hydronics2/Teardown-2019/README.md

# Teardown 2019 - Soldering and Web BLE tutorial
This is a soldering and programming class in Circuitpython that includes a Web Ble demo

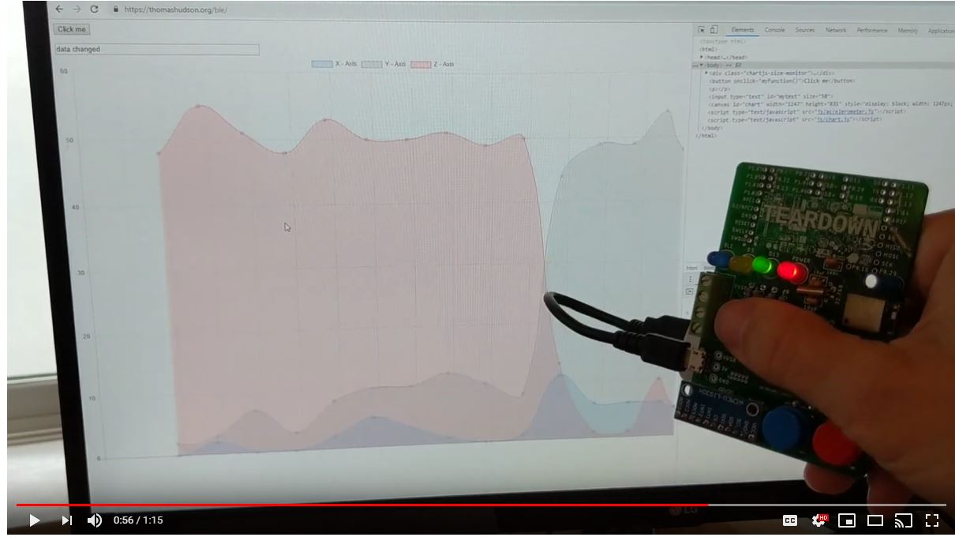
[picture p1: front_pic.JPG]
IMAGE ALT TEXT HERE (https://youtu.be/q24QmTUplko)


[github.com/hydronics2/Teardown-2019](https://github.com/hydronics2/Teardown-2019)

This class occurs in two parts -- Soldering and Programming.

We'll be soldering parts and headers  onto a custom printed circuit board(PCB).  
This board is a copy of the [Adafruit Feather nrf52840 express](https://www.adafruit.com/product/4062).  

When you connect from USB to your computer it shows up as an external hard drive with pre-loaded example scripts.

[Soldering Tutorial](https://github.com/hydronics2/Teardown-2019/blob/master/soldering/README.md)

[Programming Tutorial](https://github.com/hydronics2/Teardown-2019/blob/master/programming/README.md)

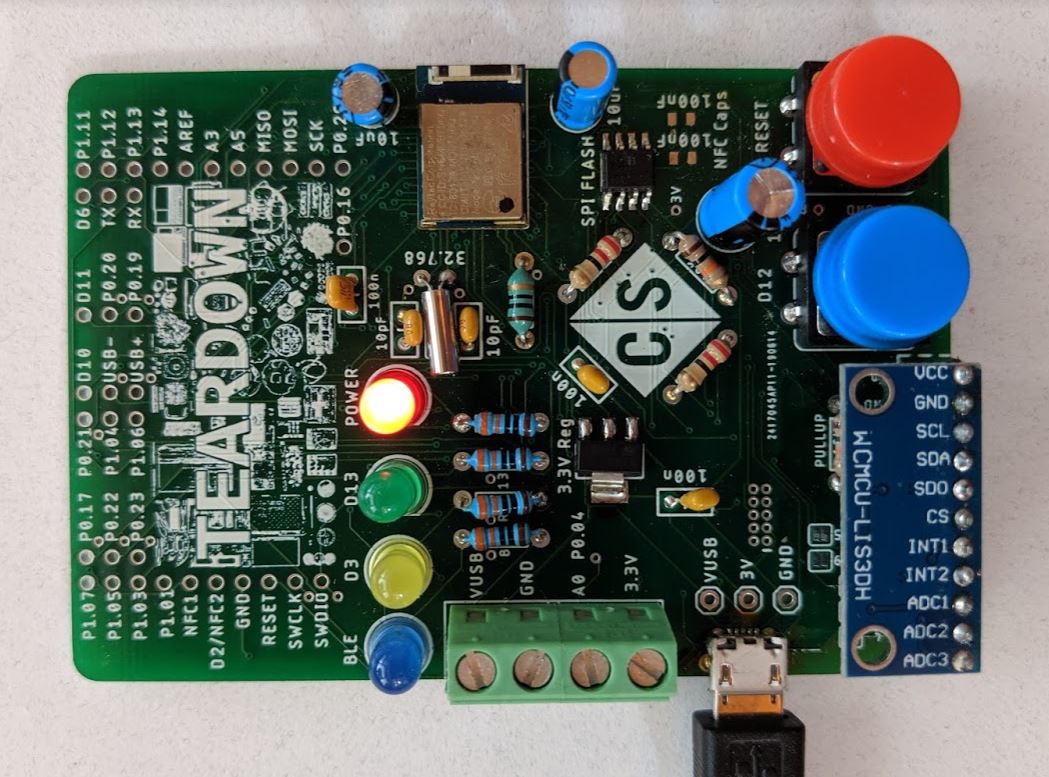
[picture p2: top.JPG]


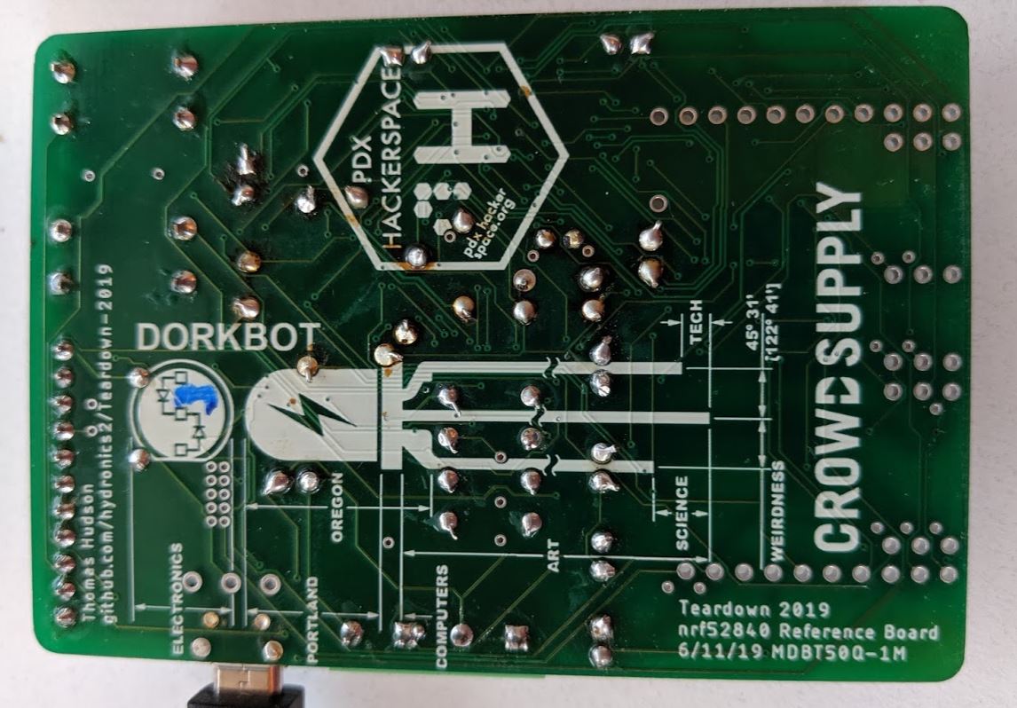
[picture p3: bottome.JPG]
