hydronics2/Teardown-2019/programming/pics/photocell.JPG

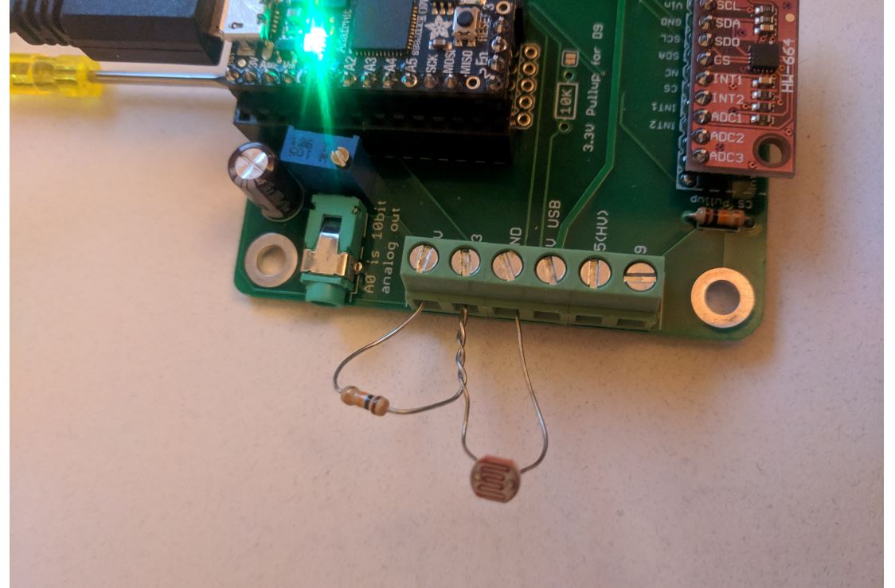
programming/pics/photocell.JPG
