hydronics2/Teardown-2019/soldering/eagle_design_files/blank_bottom.JPG

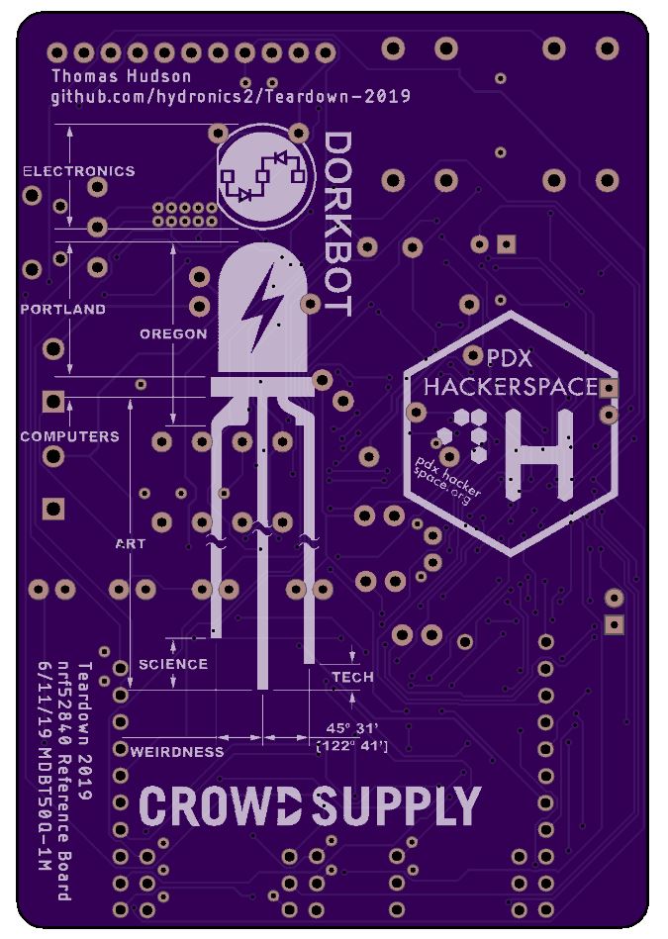
soldering/eagle_design_files/blank_bottom.JPG
