hydronics2/Teardown-2019/soldering/pics/schematic.JPG

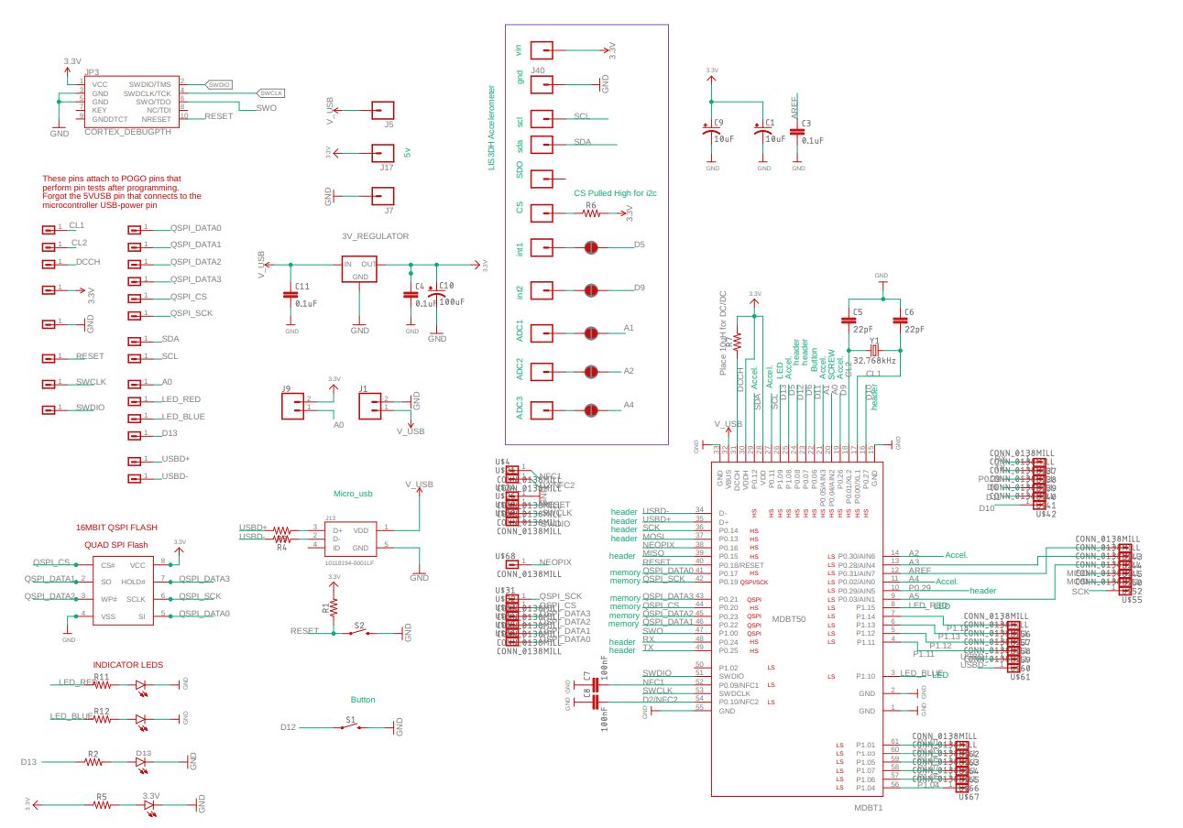
soldering/pics/schematic.JPG
