hydronics2/Teardown-2019/soldering/eagle_design_files/test-jig/README.md

# Test Jig

This test jig accepted pogo pins. Once the nrf52840 was put on the board, I used this test jig to verify all the pins were functional; that is, all the BGA(like) pads were successfully soldered. 

... need a picture of the test jig here...
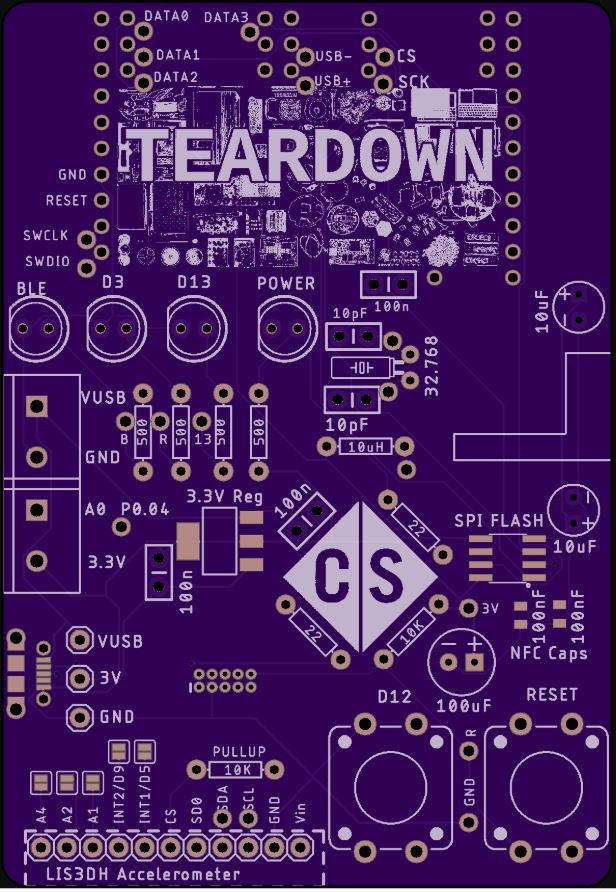
[picture p43: soldering/eagle_design_files/test-jig/test_jig_top.JPG]
test_jig
