hydronics2/Teardown-2019/soldering/eagle_design_files/class_nrf52840v2_module.sch

## EAGLE design soldering/eagle_design_files/class_nrf52840v2_module.sch (2019-06-23)

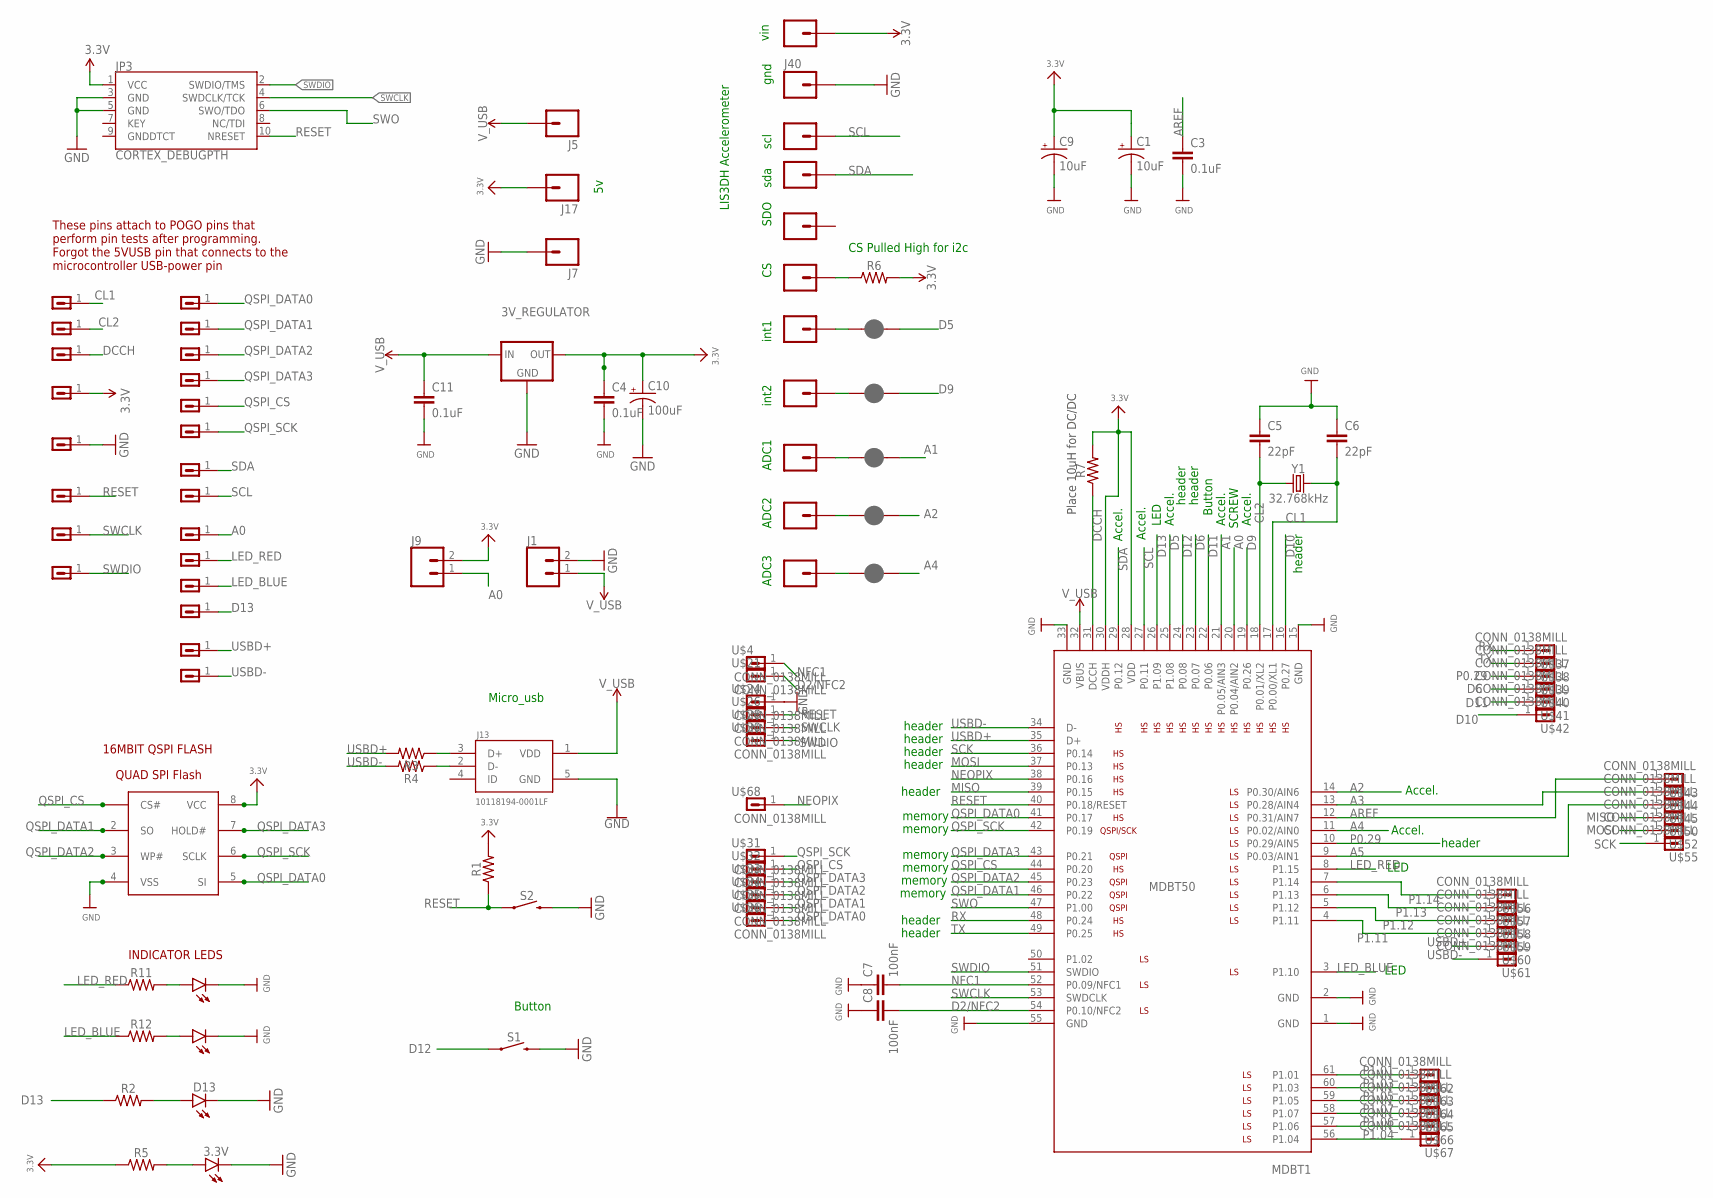
[picture p44: schematic class_nrf52840v2_module.sch]

Parts:
3.3V: LED5MM-KIT
3V_REGULATOR: LDL1117_5V_REG; SOT223
C1, C9: 10uF; CPOL-RADIAL-2.5MM-5MM-KIT
C3, C4, C11: 0.1uF; CAP-PTH-SMALL-KIT
C5, C6: 22pF; CAP-PTH-SMALL-KIT
C7, C8: 100nF; 0805
C10: 100uF; CPOL-RADIAL-2.5MM-6.5MM
D2, D3, D13: LED5MM-KIT
J1, J9: CONN_025MM; SCREWTERMINAL-5MM-2
J5, J7, J17, J22, J23, J24, J25, J26, J27, J39, J40, J42, J43, J44: M01PTH; 1X01
J13: 10118194-0001LF; FRAMATOME_10118194-0001LF
JP1, JP2, JP4, JP6, JP7: JUMPER-SMT_2_NC_PASTE_SILK; SMT-JUMPER_2_NC_PASTE_SILK
JP3: CORTEX_DEBUGPTH; 2X5-PTH-1.27MM
MDBT1: MDBT50
R1, R2, R3, R4, R5, R6, R7, R11, R12: AXIAL-0.3
S1, S2: MOMENTARY-SWITCH-SPST-PTH-12MM; TACTILE_SWITCH_PTH_12MM
U$4, U$21, U$24, U$26, U$28, U$30, U$31, U$32, U$33, U$34, U$35, U$36, U$37, U$38, U$39, U$40, U$41, U$42, U$43, U$44, U$45, U$50, U$52, U$55, U$56, U$57, U$58, U$59, U$60, U$61, U$62, U$63, U$64, U$65, U$66, U$67, U$68: CONN_0138MILL; 1X01-40MILL
U$13, U$18, U$19, U$20, U$22, U$23, U$69, U$70, U$71, U$72, U$73, U$74, U$75, U$76, U$77, U$78, U$79, U$80, U$81, U$82, U$83, U$84: CONN_011.27MM; 1X01-1.27MM
U$29: QUAD_SPI_FLASHSOIC8_300MIL; SOIC8
Y1: 32.768kHz; CRYSTAL-PTH-2X6-CYL

Connections:
3.3V: 3V_REGULATOR.2 (OUT), C1.1 (+), C4.1, C9.1 (+), C10.1 (+), J9.2, J17.1, J22.1, JP3.1 (VCC), MDBT1.28 (VDD), MDBT1.30 (VDDH), R1.P$2 (2), R5.P$1 (1), R6.P$2 (2), R7.P$2 (2), U$18.1, U$29.8 (VCC)
A0: J9.1, MDBT1.20 (P0.04/AIN2), U$76.1
A1: JP4.2, MDBT1.21 (P0.05/AIN3)
A2: JP6.2, MDBT1.14 (P0.30/AIN6)
A3: MDBT1.13 (P0.28/AIN4), U$44.1
A4: JP7.2, MDBT1.11 (P0.02/AIN0)
A5: MDBT1.9 (P0.03/AIN1), U$45.1
AREF: C3.1, MDBT1.12 (P0.31/AIN7), U$43.1
CL1: C6.2, MDBT1.17 (P0.00/XL1), U$82.1, Y1.2
CL2: C5.2, MDBT1.18 (P0.01/XL2), U$83.1, Y1.1
D2/NFC2: C8.2, MDBT1.54 (P0.10/NFC2), U$21.1
D5: JP1.2, MDBT1.25 (P1.08)
D6: MDBT1.23 (P0.07), U$40.1
D9: JP2.2, MDBT1.19 (P0.26)
D10: MDBT1.16 (P0.27), U$42.1
D11: MDBT1.22 (P0.06), U$41.1
D12: MDBT1.24 (P0.08), S1.1
D13: MDBT1.26 (P1.09), R2.P$1 (1), U$79.1
DCCH: MDBT1.31 (DCCH), R7.P$1 (1), U$84.1
GND: 3.3V.K (C), 3V_REGULATOR.1 (GND), C1.2 (-), C3.2, C4.2, C5.1, C6.1, C7.1, C8.1, C9.2 (-), C10.2 (-), C11.2, D2.K (C), D3.K (C), D13.K (C), J1.2, J7.1, J13.5 (GND), J40.1, JP3.3 (GND), JP3.5 (GND), MDBT1.1 (GND), MDBT1.2 (GND), MDBT1.15 (GND), MDBT1.33 (GND), MDBT1.55 (GND), S1.3 (2), S2.3 (2), U$13.1, U$24.1, U$29.4 (VSS)
LED_BLUE: MDBT1.3 (P1.10), R12.P$1 (1), U$78.1
LED_RED: MDBT1.8 (P1.15), R11.P$1 (1), U$77.1
MISO: MDBT1.39 (P0.15), U$50.1
MOSI: MDBT1.37 (P0.13), U$52.1
unnamed: D3.A, R11.P$2 (2)
unnamed: J13.3 (D+), R3.P$1 (1)
unnamed: J13.2 (D-), R4.P$1 (1)
unnamed: J25.1, JP4.1
unnamed: J24.1, JP6.1
unnamed: J27.1, JP7.1
unnamed: D2.A, R12.P$2 (2)
unnamed: J26.1, JP2.1
unnamed: J44.1, JP1.1
unnamed: J23.1, R6.P$1 (1)
unnamed: 3.3V.A, R5.P$2 (2)
unnamed: D13.A, R2.P$2 (2)
NEOPIX: MDBT1.38 (P0.16), U$68.1
NFC1: C7.2, MDBT1.52 (P0.09/NFC1), U$4.1
P0.29: MDBT1.10 (P0.29/AIN5), U$39.1
P1.01: MDBT1.61 (P1.01), U$62.1
P1.03: MDBT1.60 (P1.03), U$63.1
P1.04: MDBT1.56 (P1.04), U$67.1
P1.05: MDBT1.59 (P1.05), U$64.1
P1.06: MDBT1.57 (P1.06), U$66.1
P1.07: MDBT1.58 (P1.07), U$65.1
P1.11: MDBT1.4 (P1.11), U$59.1
P1.12: MDBT1.5 (P1.12), U$58.1
P1.13: MDBT1.6 (P1.13), U$57.1
P1.14: MDBT1.7 (P1.14), U$56.1
QSPI_CS: MDBT1.44 (P0.20), U$29.1 (CS#), U$32.1, U$72.1
QSPI_DATA0: MDBT1.41 (P0.17), U$23.1, U$29.5 (SI), U$36.1
QSPI_DATA1: MDBT1.46 (P0.22), U$29.2 (SO), U$35.1, U$69.1
QSPI_DATA2: MDBT1.45 (P0.23), U$29.3 (WP#), U$34.1, U$70.1
QSPI_DATA3: MDBT1.43 (P0.21), U$29.7 (HOLD#), U$33.1, U$71.1
QSPI_SCK: MDBT1.42 (P0.19), U$29.6 (SCLK), U$31.1, U$73.1
RESET: JP3.10 (NRESET), MDBT1.40 (P0.18/RESET), R1.P$1 (1), S2.1, U$20.1, U$26.1
RX: MDBT1.48 (P0.24), U$37.1
SCK: MDBT1.36 (P0.14), U$55.1
SCL: J43.1, MDBT1.27 (P0.11), U$75.1
SDA: J42.1, MDBT1.29 (P0.12), U$74.1
SWCLK: JP3.4 (SWDCLK/TCK), MDBT1.53 (SWDCLK), U$22.1, U$28.1
SWDIO: JP3.2 (SWDIO/TMS), MDBT1.51 (SWDIO), U$19.1, U$30.1
SWO: JP3.6 (SWO/TDO), MDBT1.47 (P1.00)
TX: MDBT1.49 (P0.25), U$38.1
USBD+: MDBT1.35 (D+), R3.P$2 (2), U$60.1, U$80.1
USBD-: MDBT1.34 (D-), R4.P$2 (2), U$61.1, U$81.1
V_USB: 3V_REGULATOR.3 (IN), C11.1, J1.1, J5.1, J13.1 (VDD), MDBT1.32 (VBUS)

Notes on the sheet:
Micro_usb
Place 10uH for DC/DC
16MBIT QSPI FLASH
INDICATOR LEDS
vin
SDO
gnd
sda
scl
int1
LIS3DH Accelerometer
CS Pulled High for i2c
int2
LED
Accel.
ADC1
ADC2
ADC3
SCREW
memory
header
Button
These pins attach to POGO pins that perform pin tests after programming. Forgot the 5VUSB pin that connects to the microcontroller USB-power pin
