hydronics2/Teardown-2019/soldering/eagle_design_files/test-jig/test_jig.sch

## EAGLE design soldering/eagle_design_files/test-jig/test_jig.sch (2019-06-23)

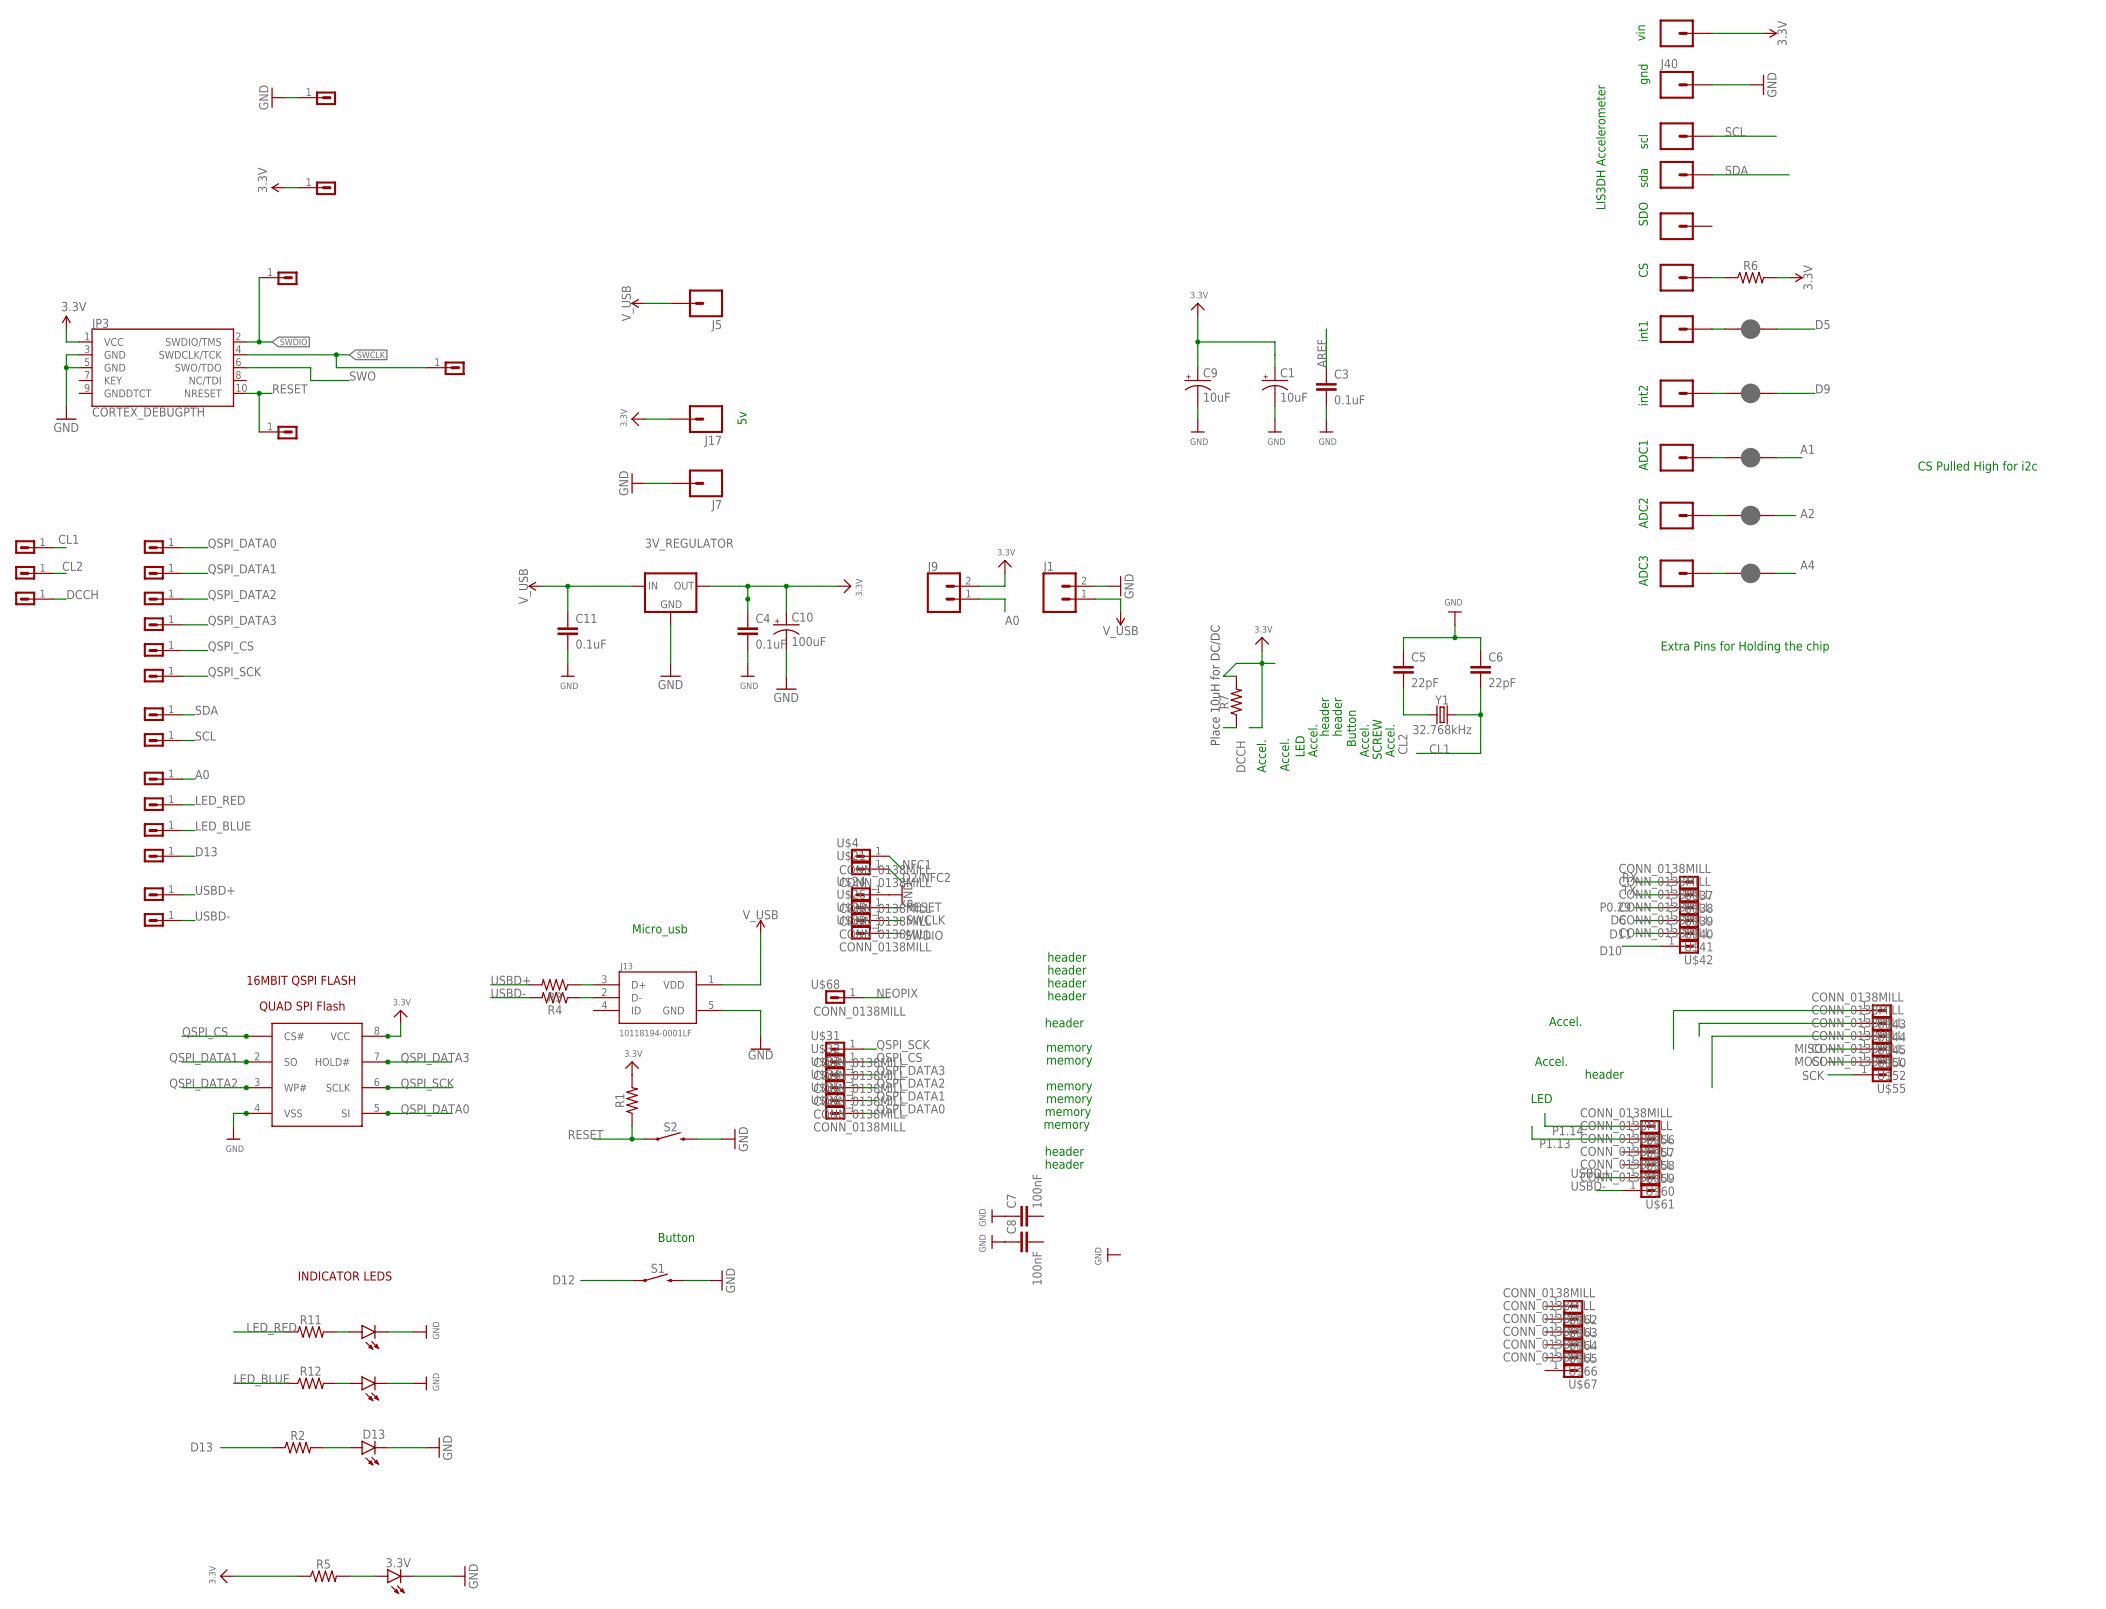
[picture p45: schematic test_jig.sch]

Parts:
3.3V: LED5MM-KIT
3V_REGULATOR: LDL1117_5V_REG; SOT223
C1, C9: 10uF; CPOL-RADIAL-2.5MM-5MM-KIT
C3, C4, C11: 0.1uF; CAP-PTH-SMALL-KIT
C5, C6: 22pF; CAP-PTH-SMALL-KIT
C7, C8: 100nF; 0805
C10: 100uF; CPOL-RADIAL-2.5MM-6.5MM
D2, D3, D13: LED5MM-KIT
J1, J9: CONN_025MM; SCREWTERMINAL-5MM-2
J5, J7, J17, J22, J23, J24, J25, J26, J27, J39, J40, J42, J43, J44: M01PTH; 1X01
J13: 10118194-0001LF; FRAMATOME_10118194-0001LF
JP1, JP2, JP4, JP6, JP7: JUMPER-SMT_2_NC_PASTE_SILK; SMT-JUMPER_2_NC_PASTE_SILK
JP3: CORTEX_DEBUGPTH; 2X5-PTH-1.27MM
R1, R2, R3, R4, R5, R6, R7, R11, R12: AXIAL-0.3
S1, S2: MOMENTARY-SWITCH-SPST-PTH-12MM; TACTILE_SWITCH_PTH_12MM
U$4, U$21, U$24, U$26, U$28, U$30, U$31, U$32, U$33, U$34, U$35, U$36, U$37, U$38, U$39, U$40, U$41, U$42, U$43, U$44, U$45, U$50, U$52, U$55, U$56, U$57, U$58, U$59, U$60, U$61, U$62, U$63, U$64, U$65, U$66, U$67, U$68: CONN_0138MILL; 1X01-40MILL
U$13, U$18, U$19, U$20, U$22, U$23, U$69, U$70, U$71, U$72, U$73, U$74, U$75, U$76, U$77, U$78, U$79, U$80, U$81, U$82, U$83, U$84: CONN_0143MILL; 1X01-43MILL
U$29: QUAD_SPI_FLASHSOIC8_300MIL; SOIC8
Y1: 32.768kHz; CRYSTAL-PTH-2X6-CYL

Connections:
3.3V: 3V_REGULATOR.2 (OUT), C1.1 (+), C4.1, C9.1 (+), C10.1 (+), J9.2, J17.1, J22.1, JP3.1 (VCC), R1.P$2 (2), R5.P$1 (1), R6.P$2 (2), R7.P$2 (2), U$18.1, U$29.8 (VCC)
A0: J9.1, U$76.1
A1: JP4.2
A2: JP6.2
A3: U$44.1
A4: JP7.2
A5: U$45.1
AREF: C3.1, U$43.1
CL1: C6.2, U$82.1, Y1.2
CL2: C5.2, U$83.1, Y1.1
D2/NFC2: U$21.1
D5: JP1.2
D6: U$40.1
D9: JP2.2
D10: U$42.1
D11: U$41.1
D12: S1.1
D13: R2.P$1 (1), U$79.1
DCCH: R7.P$1 (1), U$84.1
GND: 3.3V.K (C), 3V_REGULATOR.1 (GND), C1.2 (-), C3.2, C4.2, C5.1, C6.1, C7.1, C8.1, C9.2 (-), C10.2 (-), C11.2, D2.K (C), D3.K (C), D13.K (C), J1.2, J7.1, J13.5 (GND), J40.1, JP3.3 (GND), JP3.5 (GND), S1.3 (2), S2.3 (2), U$13.1, U$24.1, U$29.4 (VSS)
LED_BLUE: R12.P$1 (1), U$78.1
LED_RED: R11.P$1 (1), U$77.1
MISO: U$50.1
MOSI: U$52.1
unnamed: D3.A, R11.P$2 (2)
unnamed: J13.3 (D+), R3.P$1 (1)
unnamed: J13.2 (D-), R4.P$1 (1)
unnamed: J25.1, JP4.1
unnamed: J24.1, JP6.1
unnamed: J27.1, JP7.1
unnamed: D2.A, R12.P$2 (2)
unnamed: J26.1, JP2.1
unnamed: J44.1, JP1.1
unnamed: J23.1, R6.P$1 (1)
unnamed: 3.3V.A, R5.P$2 (2)
unnamed: D13.A, R2.P$2 (2)
NEOPIX: U$68.1
NFC1: U$4.1
P0.29: U$39.1
P1.13: U$57.1
P1.14: U$56.1
QSPI_CS: U$29.1 (CS#), U$32.1, U$72.1
QSPI_DATA0: U$23.1, U$29.5 (SI), U$36.1
QSPI_DATA1: U$29.2 (SO), U$35.1, U$69.1
QSPI_DATA2: U$29.3 (WP#), U$34.1, U$70.1
QSPI_DATA3: U$29.7 (HOLD#), U$33.1, U$71.1
QSPI_SCK: U$29.6 (SCLK), U$31.1, U$73.1
RESET: JP3.10 (NRESET), R1.P$1 (1), S2.1, U$20.1, U$26.1
RX: U$37.1
SCK: U$55.1
SCL: J43.1, U$75.1
SDA: J42.1, U$74.1
SWCLK: JP3.4 (SWDCLK/TCK), U$22.1, U$28.1
SWDIO: JP3.2 (SWDIO/TMS), U$19.1, U$30.1
SWO: JP3.6 (SWO/TDO)
TX: U$38.1
USBD+: R3.P$2 (2), U$60.1, U$80.1
USBD-: R4.P$2 (2), U$61.1, U$81.1
V_USB: 3V_REGULATOR.3 (IN), C11.1, J1.1, J5.1, J13.1 (VDD)

Notes on the sheet:
Micro_usb
Place 10uH for DC/DC
16MBIT QSPI FLASH
INDICATOR LEDS
vin
SDO
gnd
sda
scl
int1
LIS3DH Accelerometer
CS Pulled High for i2c
int2
Extra Pins for Holding the chip
LED
Accel.
ADC1
ADC2
ADC3
SCREW
memory
header
Button
