hydronics2/Teardown-2019/programming/python_files/code.py

# this is code.py. Code.py is the first script to execute.... so whatever is here will run

# see below all the python scripts. remove the '#' one at a time to run the script.
# they start with a1,a2,a3 because python doesn't like files starting with numbers: 1_, 2_

#import blink
#import accelerometer_led # ... working!
#import ws2812_example
#import analog_in_example
import blue_tooth_advertising
#import pwm_example
#import play_tone
