hydronics2/Teardown-2019/(commit log)

2019-06-22 new class
    [PCC_hat3.brd, PCC_hat3.sch]
2019-06-23 test jig files
    [test_jig.sch]
